joschmaCYU/Quadruped/README.md

# YMA Quadruped ROS2
Gemini_Generated_Image_kb07otkb07otkb07(2)
<br>

This repo is for my quadruped robot (code, 3D files, etc.). <br>
This walking robot can autonomously navigate thanks to Nav2 and SLAM. I built this with ROS 2 Jazzy, running on an ESP32 and a Raspberry Pi.<br>
My goal is to show examples of how to make your own autonomous quadruped with ROS 2.<br>
## What it can do autonomusly
https://github.com/user-attachments/assets/3d5b31a4-0d8b-42e6-84e3-0cbd97a148bf

## Why making a quadruped
The short answer is: **To learn!** The real answer is: To prepare for my futur internship at mitacs globalink research internship at the University of Calgary (in the Robotarium Lab).

During this internship, my primary mission will be the development of a complete ROS software architecture for a life-size quadruped robot designed to operate to safely deploy into dangerous, hard-to-reach environments—such as disaster zones, collapsed structures, or hazardous industrial sites—means keeping human responders out of harm's way... 

# Installation
```
cd ~/ros2_ws/src
git clone https://github.com/joschmaCYU/quadruped/
cd quadruped/docker
bash build.sh
```
# Usage
You can either use the GUI:
```
python3 src/quadruped_basics/dashboard.py
```
Or you can use the terminal
## For sim
```
ros2 launch quadruped sim.amcl.launch.py
```
or 
```
ros2 launch quadruped sim.slam.launch.py
```
## For the real robot
```
ros2 launch quadruped real.amcl.launch.py
```
or
```
ros2 launch quadruped real.slam.launch.py
```

TODO vu éclaté

# Tutorial -your turn to build:
Follow these steps to build your own quadruped !

### 0 - What will my robot do ?
The first question you have to ask your self and the most important one is: *what will my robot do ?*<br>
For me, I want my robot to autonomously navigate a semi-controlled environement.

### 1 - Parts
Now that you have defined your goals you need to pick your parts.<br>
I choose:
- Compute: Raspberry Pi 4 (Main ROS 2 brain) and ESP32 (Servo controller)
- Actuators: 8x MG90S Micro Servos
- Sensors: 2D LiDAR (for SLAM/Navigation) and an IMU
> [!WARNING]
> You should really use an IMU else the odometry will be very difficult to work with

For more details see [parts](https://github.com/joschmaCYU/quadruped/blob/main/PartsREADME.md)

### 2 - Print & Assemble
Now that you know what we have to fit in our robot lets design it. Use your favorite CAD software and create your URDF file.<br>
For more help see [print](https://github.com/joschmaCYU/quadruped/blob/main/PrintREADME.md)

### 3 - Simulating the robot and let's use ROS
Now that you have your urdf file we can simulate it!<br>
The robot runs on ROS 2 Jazzy. It handles the communication between the sensors, actuators, the Pi, and the ESP32. <br> 
[Let's bring your robot to sim](https://github.com/joschmaCYU/quadruped/blob/main/SimREADME.md)<br>

#### Teleoperation
Now that you implemented everything to make the robot let's make it move!<br>
You will have to [launch gz-sim and run the urdf spawn script](https://gazebosim.org/docs/latest/spawn_urdf/)<br>
```ros2 run teleop_twist_keyboard teleop_twist_keyboard --ros-args -p use_sim_time:=true```
<br>

https://github.com/user-attachments/assets/2a4f5992-fd1c-4fa5-9b9c-b5832c5c24f9

<details>
<summary>Click to view the summary of ros2 topics (for sim):</summary>
    
```mermaid
graph TD
    %% Define Styles
    classDef input fill:#27ae60,stroke:#2ecc71,stroke-width:2px,color:#fff
    classDef core fill:#8e44ad,stroke:#9b59b6,stroke-width:2px,color:#fff
    classDef sim fill:#d35400,stroke:#e67e22,stroke-width:2px,color:#fff
    classDef viz fill:#2980b9,stroke:#3498db,stroke-width:2px,color:#fff

    subgraph User_Input ["User Control"]
        TELEOP("teleop_twist_keyboard<br>(or Joystick)"):::input
    end

    subgraph ROS2_Logic ["ROS 2 Brain"]
        IK_NODE("ik_node.py<br>(Quadruped Kinematics)"):::core
        RSP("robot_state_publisher<br>(URDF Parsing)"):::core
    end

    subgraph Simulation ["Gazebo Physics Engine"]
        BRIDGE("ros_gz_bridge<br>(Sensor Translator)"):::sim
        R2C("ros2_control<br>(Virtual Servos)"):::sim
    end

    subgraph Mapping_and_Viz ["Mapping & Visualization"]
        SLAM("SLAM Toolbox"):::viz
        RVIZ("RViz 2"):::viz
    end

    %% --- COMMAND FLOW (How it moves) ---
    TELEOP -->|" /cmd_vel (Twist)"| IK_NODE
    IK_NODE -->|" /joint_group_position_controller/commands"| R2C
    
    %% --- SENSOR FLOW (How it sees/feels) ---
    BRIDGE -->|" /imu (Imu)"| IK_NODE
    BRIDGE -->|" /scan (LaserScan)"| SLAM
    BRIDGE -->|" /scan (LaserScan)"| RVIZ
    
    %% --- ODOMETRY & MAPPING FLOW ---
    IK_NODE -->|" /odom (Odometry)"| SLAM
    IK_NODE -->|" /odom (Odometry)"| RVIZ
    SLAM -->|" /map (OccupancyGrid)"| RVIZ

    %% --- TF TREE (Coordinate Math - Dotted Lines) ---
    SLAM -.->|" /tf (map -> odom)"| RVIZ
    IK_NODE -.->|" /tf (odom -> base_footprint)"| RVIZ
    RSP -.->|" /tf_static (Body Links)"| RVIZ
```

</details>
    
### 4 - Navigation (SLAM & AMCL)
Now that your robot exists in simulation, it needs to understand its environment. In the ROS 2 world, we use a combination of SLAM (to draw the map) and AMCL (to localize the robot within that map). <br>
[Learn how to configure and tune Nav2 for a quadruped](NavigationREADME.md)

### 5 - Building the physical robot
Time to move from Gazebo to the real world. Putting the hardware together requires careful power management and wire routing. <br>
[See the assembly guide, wiring rules, and power management](HardwareREADME.md)

### 6 - Sim to life (the micro-ROS bridge)
The magic of ROS 2 is that the "brain" (your Python kinematics and Nav2 planners) does not care if the robot is a Gazebo simulation or physical plastic. To bridge the physical hardware to the ROS 2 network, we use an ESP32 running Micro-ROS and a Raspberry Pi acting as the agent. <br>
[Learn how to flash the ESP32 and bridge it to ROS 2](RealRobotREADME.md)

If the robot doesn't start see FAQ<br>

Once the Micro-ROS agent connects, your physical robot is officially online and will execute the exact same walk cycles you perfected in the simulator. Use SLAM or AMCL or teleoperation to make it move!
<br>
<details>
<summary>Click to view the summary of our ros2 topics when running the real robot</summary>
    
```mermaid
graph TD
    %% Define Styles
    classDef autonomy fill:#2980b9,stroke:#3498db,stroke-width:2px,color:#fff
    classDef core fill:#8e44ad,stroke:#9b59b6,stroke-width:2px,color:#fff
    classDef drivers fill:#c0392b,stroke:#e74c3c,stroke-width:2px,color:#fff
    classDef mros fill:#27ae60,stroke:#2ecc71,stroke-width:2px,color:#fff
    
    subgraph High_Level_Autonomy ["High-Level Autonomy (Nav2 & SLAM)"]
        NAV2("Nav2 Stack<br>(Planner, Controller, BT Navigator)"):::autonomy
        SLAM("SLAM Toolbox<br>(Map Generation)"):::autonomy
    end

    subgraph Robot_Core_Logic ["Robot Core Logic"]
        IK_NODE("ik_node.py<br>(Quadruped Kinematics)"):::core
        RSP("robot_state_publisher<br>(URDF Parsing)"):::core
        TF_STATIC("static_transform_publisher<br>(base_footprint -> base_laser)"):::core
    end

    subgraph Hardware_Drivers ["Hardware Drivers"]
        LIDAR_NODE("ldlidar_stl_ros2_node"):::drivers
        AGENT("micro_ros_agent<br>(Serial Bridge)"):::mros
    end

    subgraph ESP32_Microcontroller ["ESP32 (Micro-ROS Node)"]
        ESP_NODE("ESP32<br>(IMU & Servo Control)"):::mros
    end

    %% --- TOPIC CONNECTIONS (Data Flow) ---
    
    %% Sensors to Brain
    LIDAR_NODE -->|"/scan (LaserScan)"| SLAM
    LIDAR_NODE -->|"/scan (LaserScan)"| NAV2
    
    %% Movement Commands
    NAV2 -->|"/cmd_vel (Twist)"| IK_NODE
    
    %% Kinematics to Hardware
    IK_NODE -->|"/joint_group_position_controller/commands"| AGENT
    AGENT ====|"UART/Serial Bridge"| ESP_NODE
    
    %% Hardware Feedback to Brain
    ESP_NODE ====|"UART/Serial Bridge"| AGENT
    AGENT -->|"/imu (Imu)"| IK_NODE
    AGENT -->|"/imu (Imu)"| NAV2
    
    %% Odometry Feedback
    IK_NODE -->|"/odom (Odometry)"| NAV2
    IK_NODE -->|"/odom (Odometry)"| SLAM

    %% --- TF TREE CONNECTIONS (Coordinate Math - Dotted Lines) ---
    SLAM -.->|"/tf (map -> odom)"| NAV2
    IK_NODE -.->|"/tf (odom -> base_footprint)"| NAV2
    RSP -.->|"/tf_static (Body Links)"| NAV2
    TF_STATIC -.->|"/tf_static (base_laser)"| NAV2
```

</details>
<details>
<summary>FAQ</summary>
<details><summary>Why is my robot not walking</summary>
There could be multiple reasons. But I will help you.<br>
1) My esp32 doesn't connect to micro ros.<br>
Make sure to have your lidar pluged.<br>
If it blinks kickly 7 times it can't connect to the IMU.<br>
If it blinks 1 time it can't connect to ros. There could be multiple <a href="https://github.com/joschmaCYU/quadruped/blob/main/docker/cheatsheet.md#if-robot-not-connecting-">solutions</a><br>
If it blinks very quickly multiple time per second are your servos getting power ?<br>
</details>
<details><summary>Should I program in Python or C++ ?</summary>
At the start for quick iteration you can use python and if the performance requires it switch to c++. <br><br>
</details>
</details>
