joschmaCYU/Quadruped/src/quadruped_basics/meshes/mainBody-MainBodyUpper_Rasp.stl

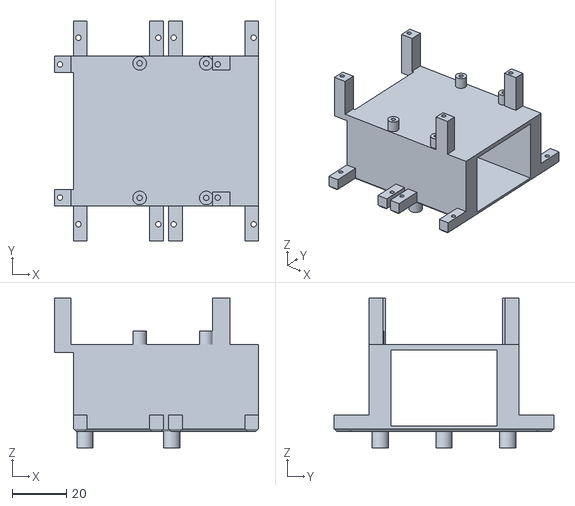
[picture p1: CAD file, 2026-06-22]
src/quadruped_basics/meshes/mainBody-MainBodyUpper_Rasp.stl
75.0 x 81.0 x 55.0
