joschmaCYU/Quadruped/src/quadruped_basics/meshes/Quadruped-Assembly.stl

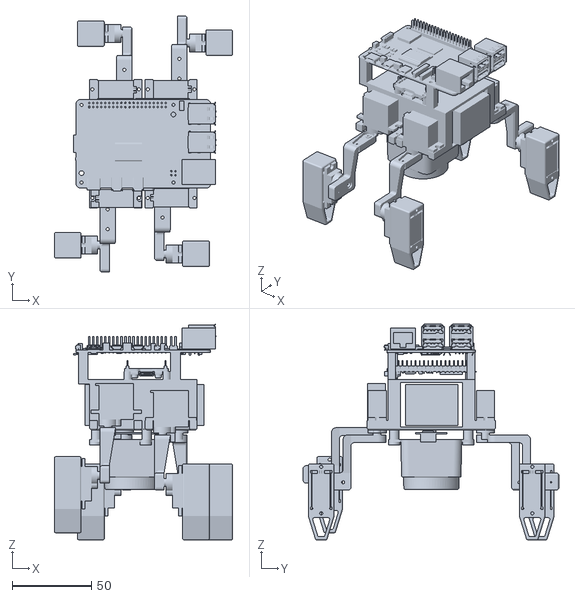
[picture p2: CAD file, 2026-06-22]
src/quadruped_basics/meshes/Quadruped-Assembly.stl
112.6 x 161.6 x 136.2
