joschmaCYU/Quadruped/src/quadruped_basics/meshes/Leg-Assembly.stl

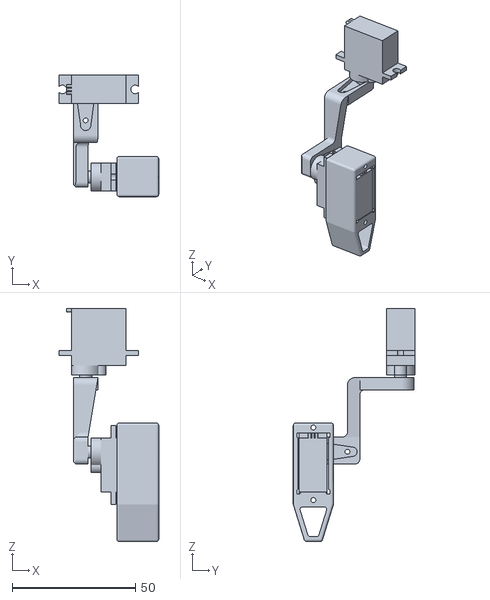
[picture p3: CAD file, 2026-05-21]
src/quadruped_basics/meshes/Leg-Assembly.stl
40.3 x 49.2 x 94.3
