joschmaCYU/Quadruped/src/quadruped_basics/meshes/linkV3Front-UpperLink.3mf

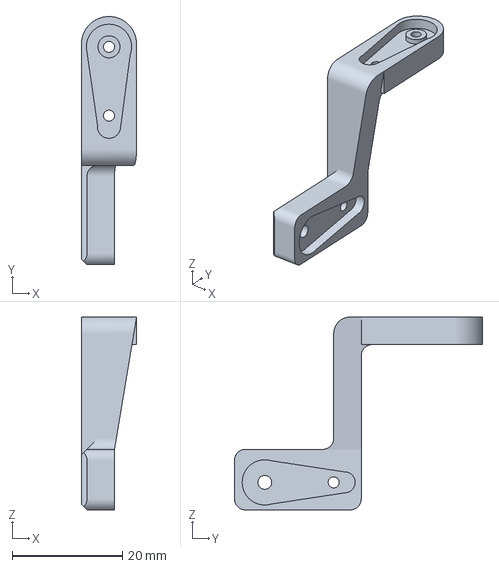
[picture p4: CAD file, 2026-06-22]
src/quadruped_basics/meshes/linkV3Front-UpperLink.3mf
10.0 x 45.0 x 35.0 mm
