joschmaCYU/Quadruped/src/quadruped_basics/meshes/LowerLegV2-LowerLeg.stl

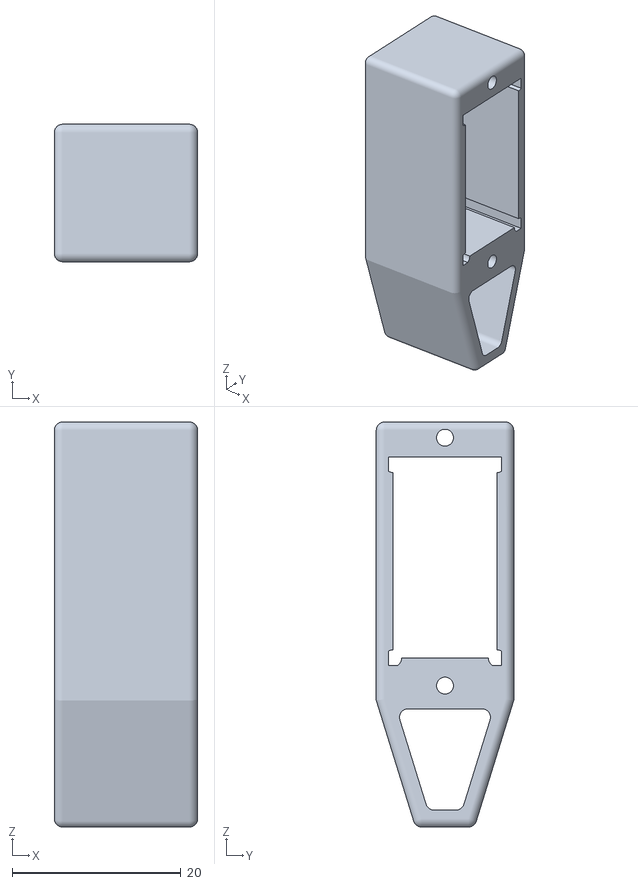
[picture p5: CAD file, 2026-06-22]
src/quadruped_basics/meshes/LowerLegV2-LowerLeg.stl
17.0 x 16.3 x 48.0
