joschmaCYU/Quadruped/(list of files, cad)

Other CAD files:
src/quadruped_basics/meshes/linkV3Back-UpperLink.3mf
