joschmaCYU/Quadruped/(commit log)

2026-03-17 Add everything
    [quad.urdf.xacro]
2026-03-17 moving legs !
2026-03-24 Moving GZ simulation
    [controllers.yaml, quad.urdf.xacro]
2026-03-25 walks good forward!
    [quad.urdf.xacro]
2026-03-27 IL TOURNE
    [quad.urdf.xacro, sim_controllers.yaml]
2026-03-27 added lidar
    [quad.urdf.xacro]
2026-04-03 Works with nav2
    [box_fort.sdf, quad.urdf.xacro]
2026-04-06 better turn and new map
    [better_world.sdf, better_worlds.sdf, quad.urdf.xacro]
2026-04-07 updated urdf robot sim file with real weight
2026-04-24 changed from amcl to slam works much better with my shitty odometry! Found a better truning mult
    [better_world.sdf, box_fort.sdf, fullbox.sdf]
2026-04-30 Fixed sim now works with lidar for real robot!
    [better_world.sdf, box_fort.sdf, controllers.yaml, fullbox.sdf, quad.urdf.xacro, sim_controllers.yaml]
2026-05-13 added IMU to sim
    [box_fort.sdf, quad.urdf.xacro]
2026-05-14 added IMU for real robot
2026-05-17 if arm build then do not install gz
2026-05-17 remove frames files
2026-05-21 Finally the robot is walking with slam + better readme
    [Leg-Assembly.stl, better_world.sdf, box_fort.sdf, controllers.yaml, fullbox.sdf, quad.urdf.xacro, sim_controllers.yaml]
2026-05-26 removed lidar package from git clone
2026-05-28 better arduino code & better ik_node changed & changed nav2 params
2026-06-15 better parts print and sim readme
2026-06-22 added meshs
    [LowerLegV2-LowerLeg.stl, Quadruped-Assembly.stl, linkV3Back-UpperLink.3mf, linkV3Front-UpperLink.3mf, mainBody-MainBodyUpper_Rasp.stl]
